HSchmale16/Project1_auto-aquaponics/Controller/Controller.ino

#include <OneWire.h>
#include <DallasTemperature.h>
#include <Adafruit_Sensor.h>
#include <DHT.h>

#define DHTTYPE DHT11

/**
 * AutoAquaponics Sensor Controller
 * Henry J Schmale
 * December 21, 2016
 *
 * Handles the reading and controlling of the sensors and relays
 * attached to the arduino. The NUC controls the arduino via
 * a serial port. 
 */

/**
 * Defines an action that the machine can take.
 */
struct CommandAction {
    // The code used to look it up
    String code;
    // use a function pointer to determine the action to take
    void (*action)();
};

// All possible actions that the machine can take.
// sensor readings are more common than toggling actions
const CommandAction ACTIONS[] = {
    {"rWatThm", readWaterThermometer},
    {"rdWaLvl", readWaterLevel},
    {"rdHumid", readHumidity},
    {"rdAirTm", readAirThermometer},
    // negate the current actions
    {"nLights", yesLights},
    {"nAirPmp", yesAirPump},
    {"nCiPump", yesCircPump},
    // activates the actions
    {"yLights", noLights},
    {"yAirPmp", noAirPump},
    {"yCiPump", noCircPump},
};

// Total Number of Possible Actions
const int ACTION_COUNT = sizeof(ACTIONS) / sizeof(CommandAction); 

// Define the pins used
// Configure DHT 11
const int PIN_DHT_POWER = 34;
const int PIN_DHT_GND   = 30;
const int PIN_DHT11     = 32;
// DallasTemperature Sensor
const int ONE_WIRE_POW  = 52;
const int ONE_WIRE_BUS  = 50;
const int ONE_WIRE_GND  = 48;
// Distance Finder
const int PIN_DIS_POW  = 47;
const int PIN_TRIGGER  = 45;
const int PIN_ECHO     = 43;
const int PIN_DIS_GND  = 41;
// Relay control pins
const int RELAY_BOARD_LOWER = 14;
const int RELAY_BOARD_UPPER = 18;
const int PIN_PUMP = RELAY_BOARD_LOWER + 1;
const int PIN_LIGHTS = RELAY_BOARD_LOWER + 2;
const int PIN_AIR_PUMP =  RELAY_BOARD_LOWER + 3;

 /* Temperature and Humidity Sensor
 */
DHT dht(PIN_DHT11, DHTTYPE);

/* Setup water temperature sensor
 */
OneWire oneWire(ONE_WIRE_BUS);
DallasTemperature sensors(&oneWire);

void setup() {
    Serial.begin(9600);
    // setup the various sensors on the OneWire bus
    sensors.begin();
    // setup the pins for the echo sensor.
    pinMode(PIN_TRIGGER, OUTPUT);
    pinMode(PIN_ECHO, INPUT);
    pinMode(PIN_DIS_POW, OUTPUT);
    pinMode(PIN_DIS_GND, OUTPUT);
    digitalWrite(PIN_DIS_POW, HIGH);
    digitalWrite(PIN_DIS_GND, LOW);
    
    // configure dallas temp sensor power
    pinMode(ONE_WIRE_POW, OUTPUT);
    pinMode(ONE_WIRE_GND, OUTPUT);
    digitalWrite(ONE_WIRE_POW, HIGH);
    digitalWrite(ONE_WIRE_GND, LOW);
 
    // configure dht pins
    pinMode(PIN_DHT_POWER, OUTPUT);
    pinMode(PIN_DHT_GND, OUTPUT);
    digitalWrite(PIN_DHT_POWER, HIGH);
    digitalWrite(PIN_DHT_GND, LOW);
     
    dht.begin();
 
    // setup relay pins
    for(int rp = RELAY_BOARD_LOWER; rp < RELAY_BOARD_UPPER;  rp++){
        pinMode(rp, OUTPUT);
        digitalWrite(rp, LOW);
    }
    digitalWrite(RELAY_BOARD_LOWER, LOW);
    digitalWrite(RELAY_BOARD_UPPER, HIGH);
}   
    
 void loop() {
    if(!Serial.available()){
        return;
    }
    // wait for bytes to arrive
    delay(50);
    String cmd = "";
    // while the serial is available append the current byte
    while(Serial.available()) {
        // perform a chomp operation
        if(Serial.peek() == '\n'){
            Serial.read();
            break;
        }
        cmd += (char)Serial.read(); 
    }
    // Search through possible actions and execute that action on find
    for(byte i = 0; i < ACTION_COUNT; i++){
        if(cmd.equals(ACTIONS[i].code)) {
            Serial.print(cmd);
            Serial.print(' ');
            ACTIONS[i].action();
            break;
        }
    }
}

/* Read the water temperature by using a DST18B20 Temperature Sensor
 */
void readWaterThermometer() {
    sensors.requestTemperatures();
    float tempC = sensors.getTempCByIndex(0);
    Serial.println(DallasTemperature::toFahrenheit(tempC));
}

/* Read the air temperature using a DHT11 Sensor
 */
void readAirThermometer() {
    // true -> read as fahrenheit
    Serial.println(dht.readTemperature(true));
}

/* Read the humidity using a DHT11 Sensor
 */
void readHumidity() {
    Serial.println(dht.readHumidity());
}

void readWaterLevel() {
    // delay for a clean pulse
    digitalWrite(PIN_TRIGGER, LOW);
    delay(225);
    digitalWrite(PIN_TRIGGER, HIGH);
    delayMicroseconds(5);
    digitalWrite(PIN_TRIGGER, LOW);
    
    // round trip in milliseconds
    int duration = pulseIn(PIN_ECHO, HIGH);
    
    
    Serial.println((duration / 2) / 29.1);

    delay(100);
}

// toggles the pump, and prints the current state of the pump after
// toggling it.
void yesCircPump() {
    digitalWrite(PIN_PUMP, LOW);
    // the digitalRead needs to be inverted to be in standard notion
    // because of the pull down on the pins.
    Serial.println(digitalRead(PIN_PUMP));
}

void yesLights() {
    digitalWrite(PIN_LIGHTS, LOW);
    Serial.println(digitalRead(PIN_LIGHTS));
}

void yesAirPump() {
    digitalWrite(PIN_AIR_PUMP, LOW);
    // because of the pull down on the pins.
    Serial.println(digitalRead(PIN_AIR_PUMP));
}

void noLights() {
    digitalWrite(PIN_LIGHTS, HIGH);
    Serial.println(digitalRead(PIN_LIGHTS));
}

void noAirPump() {
    digitalWrite(PIN_AIR_PUMP, HIGH);
    Serial.println(digitalRead(PIN_LIGHTS));
}

void noCircPump() {
    digitalWrite(PIN_PUMP, HIGH);
    Serial.println(digitalRead(PIN_PUMP));
}
