HSchmale16/Project1_auto-aquaponics/(commit log)

2016-12-19 Start work on the arduino code
2016-12-19 Work on the Config and Arduino Sketch
2016-12-22 Add code for the DHT11 reads.
    Add comments
    Bring in the library for reading DHT
    attach dht code reading code.
2016-12-22 Do some documentation. Add the start of ultrasonics for depth measuring
2016-12-22 Work on the database of sensors
2017-01-01 Add Controller Logic For The Relay
2017-01-02 Write Pump Toggle System.
2017-01-02 Msg Queues
    Update the names of the queues. Original names made no sense.
    Add a send msg script to notify
    Make it so that messages are recv exactly once on sensord's side
2017-01-05 Sensor readings are now added to the database
    Also update config AGAIN!!!
    Update database to include the newest readings for each sensor.
2017-01-05 Work on things
    Update config
    Input validation on the sensor daemon
    New views
    Start work on the webapp
2017-01-05 Update DB Tables and Views
    New Primary View that Joins sensor and the readings together.
    Continue work on the webapp.
2017-01-13 Config Change + Fix for the Relay Board
    [Controller.ino]
2017-01-13 Add new actions to db
    Fix error in sensord regarding action name
    [sensord.js]
2017-01-24 Switch to shinydashboard.
2017-01-24 Fix data insert issue.
2017-01-30 Get the Controller to Read Air Temperature and Humidity
2017-01-30 Add all sensors to test script & Reorder Actions in Controller
2017-02-09 Fixes Issue #1
    Timestamps are now correct for the current timezone. This means that issue
    1 can be closed. Define the vSensorReadings view in much more discrete
    terms. Also handle issue with not enough readings for the sampling.
2017-02-13 Add action toggling
    Sensord now toggles the actions, which means that only one daemon needs to
    run to handle the system, and it just uses child processes to manage it.
    Also modifiy the title of a graph in the webpage
2017-03-10 Comment the sensord much better
2017-04-04 Relayout Pins in Sketch For Efficency
    Move all sensor pins to bottom bar for ease of use
2017-04-09 Add kicad circuit
    [Circuit.kicad_pcb, Circuit.sch]
2017-04-25 Work on the email sending
    * Start work on the email sending
    * Update the config with email settings
    * Remove the old constraints file
    * Sensord
